JaineRatush/Mini-Tow-Tank/README.md

# Mini-Tow-Tank [Jun-Jul 2026]
Developed a mini tow tank to support research on bioluminescent algae as an alternative flow visualization technique. The control system uses closed-loop encoder feedback to achieve precise velocity(+/- 0.03 m/s from target) and repeatable motion, creating the flow conditions required for observing Kármán vortices in algae.

[Documentation & Instructions PDF](Documentation/MiniTowTank_Instructions&Documentation.pdf)  

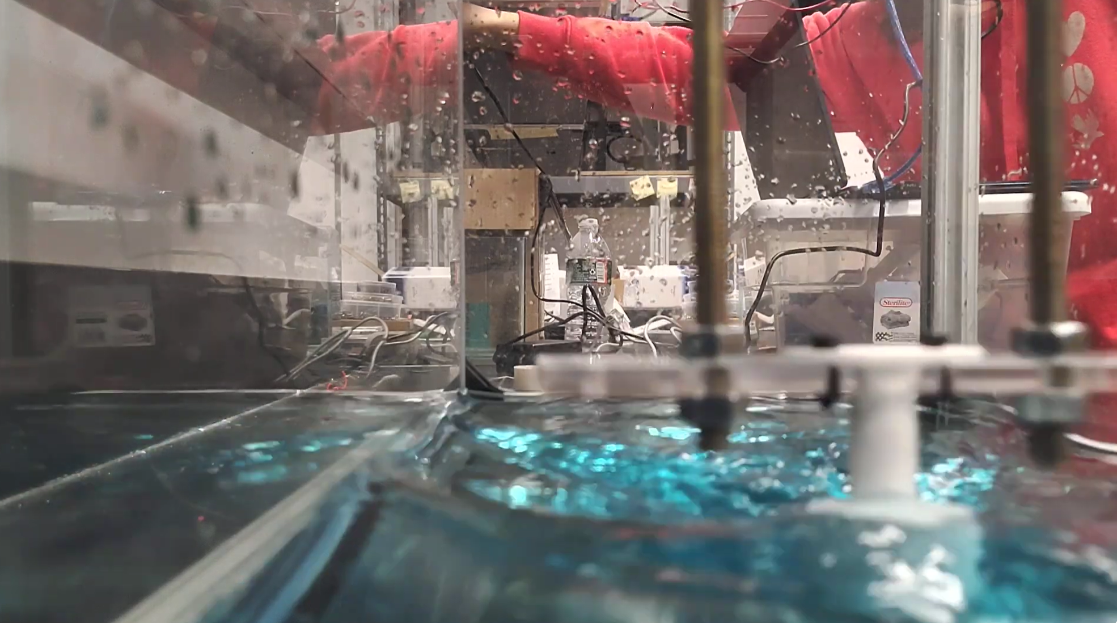
[picture p1: Photos/Thumbnail.png]
Mini Tow Tank Demo (https://www.youtube.com/watch?v=F2ftbyinyw4g)
  
Click on the image above to see it in action!  
Video link: (https://www.youtube.com/watch?v=F2ftbyinyw4)  

## Mechanical
- Applied first principles and Desmos to size and choose a DC motor, pulley diameter, determine electrical constraints, and choose the motor driver and corresponding wires (https://www.desmos.com/calculator/bqttl8z7cw)      
- Used Onshape to design and 3D print(gyroid infill to withstand shear stress) the [belt tensioner](Photos/BeltTensioner.png) sub-assembly and tow body.   
- Created a [height adjustable gantry](Photos/Gantry.jpg) (to minimize tow body deflection at any fluid level) by laser cutting acrylic and using M8 threaded rods and nuts.   
- Machined an [adapter sleeve](Photos/AdapterSleeve.jpeg) (4mm motor shaft to 5mm inner-bore pulley) using a manual mill and lathe, created a platform for electronics using a table saw and drill press  

## Controls  
- Scripted a [motor controller](Code/Tow_Tank_Motion.ino) in C++ by taking the derivative of encoder position feedback to determine velocity, and creating functions to assign motor direction based on conditional statements.   
- Scripted and tuned a PI controller with feedforward   
- Wrote a [calibration program](Code/Kff_Calibration.ino) to empirically determine baseline/feedforward PWM for a desired velocity  
 
## Electrical  
- Created an embedded circuit containing an IBT2 motor driver, Arduino Uno, DC motor, ultrasound proximity sensor, and a relative magnetic encoder.   
- Learned about the different types of Encoders(Relative/Absolute, Magnetic/Rotary/Optic)
- Learned about Single H-Bridges & MOSFETs
- Learned about Low-Pass Filters 
- Wired & Created a [Wiring diagram](Photos/Electronics.png) for the electronics:
 {Arduino, Proximity Sensor, IBT2 Motor Driver, Motor, Magnetic Encoder}
 
## Future Improvements:
Mechanical:  
-	Gantry is height adjustable, but was not designed for constant and easy adjustment. Mini Tow Tank 2.0 will have one threaded rod, and one smooth rod with clamps, allowing for faster adjustment. 
-	The Laser printed top and bottom portion of the gantry can be re-laser cut such that the nuts sit farther away from the MGN9 carriages to reduce nut-loosening vibrations. 
- In a future iteration the Go Pro should be able to be mounted on the gantry  

Controls/Electrical:  
For the next iteration the following improvements could be made:
-	Add a homing button and a stop button 
- Using an absolute encoder instead of the current relative encoder
-	Better wire management and casing for electronics

Credit to Zara Bhuiyan for helping embed/redesign the belt tensioner for the hex screw.
