JaineRatush/Mini-Tow-Tank/Photos/AdapterSleeve.jpeg

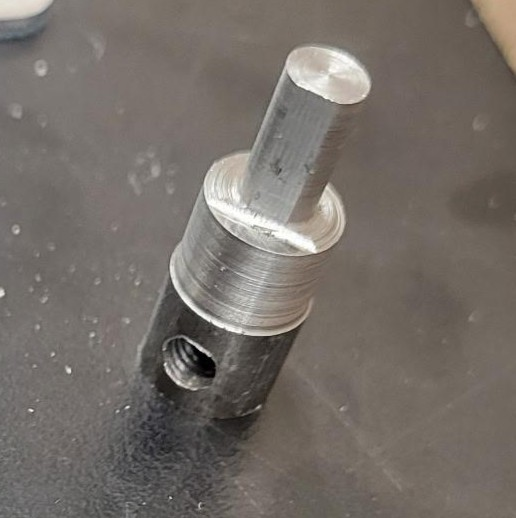
Photos/AdapterSleeve.jpeg
