JaineRatush/Mini-Tow-Tank/Photos/BeltTensioner.png

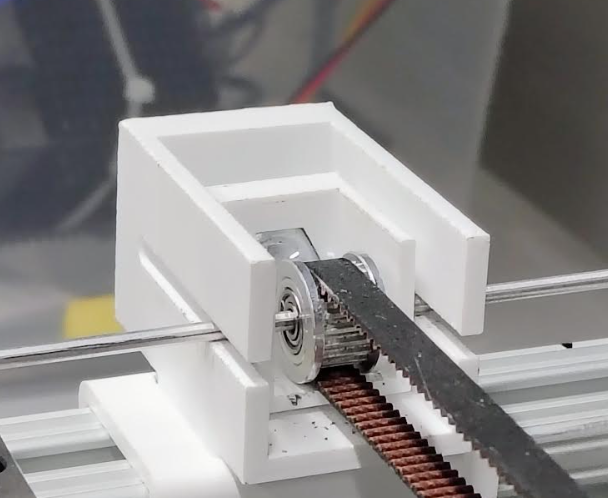
Photos/BeltTensioner.png
