JaineRatush/Mini-Tow-Tank/Photos/Electronics.png

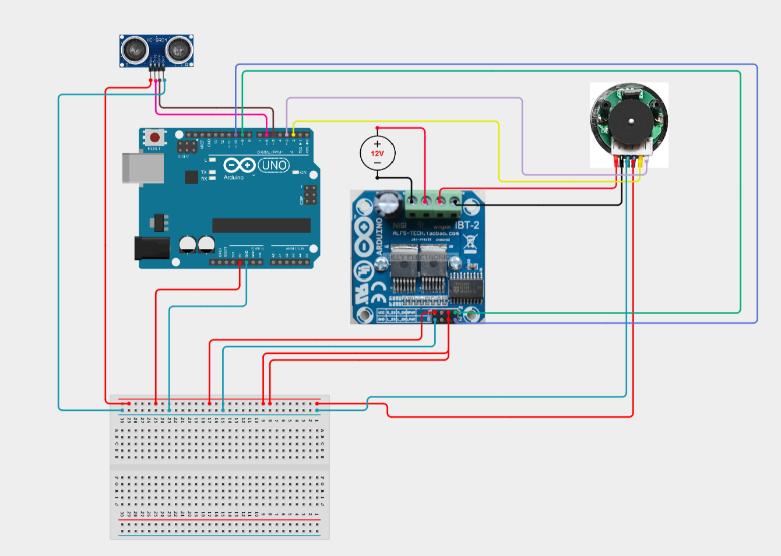
Photos/Electronics.png
