JaineRatush/Mini-Tow-Tank/Photos/Gantry.jpg

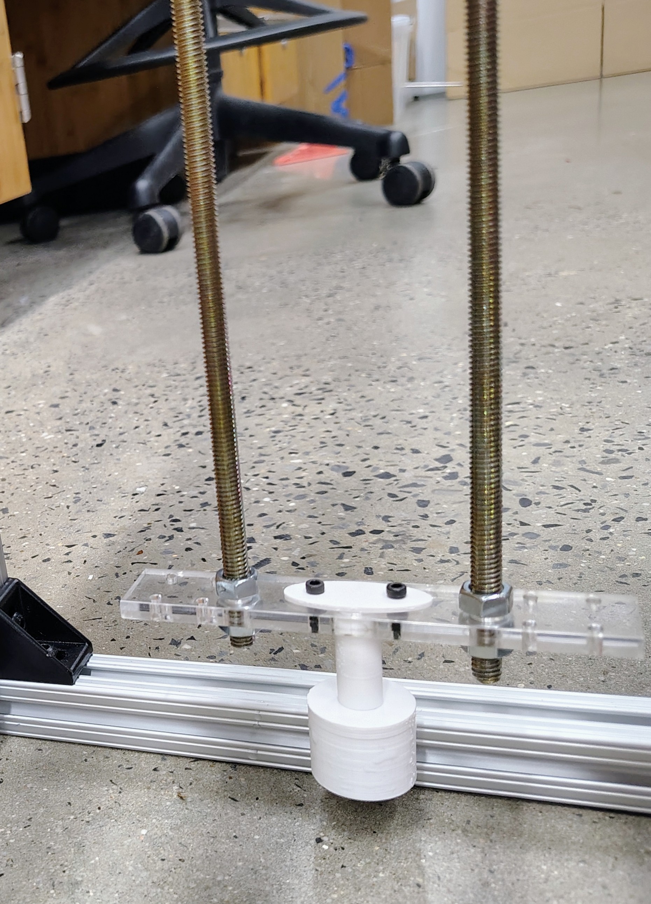
Photos/Gantry.jpg
