JaineRatush/Mini-Tow-Tank/Photos/Isometric.jpg

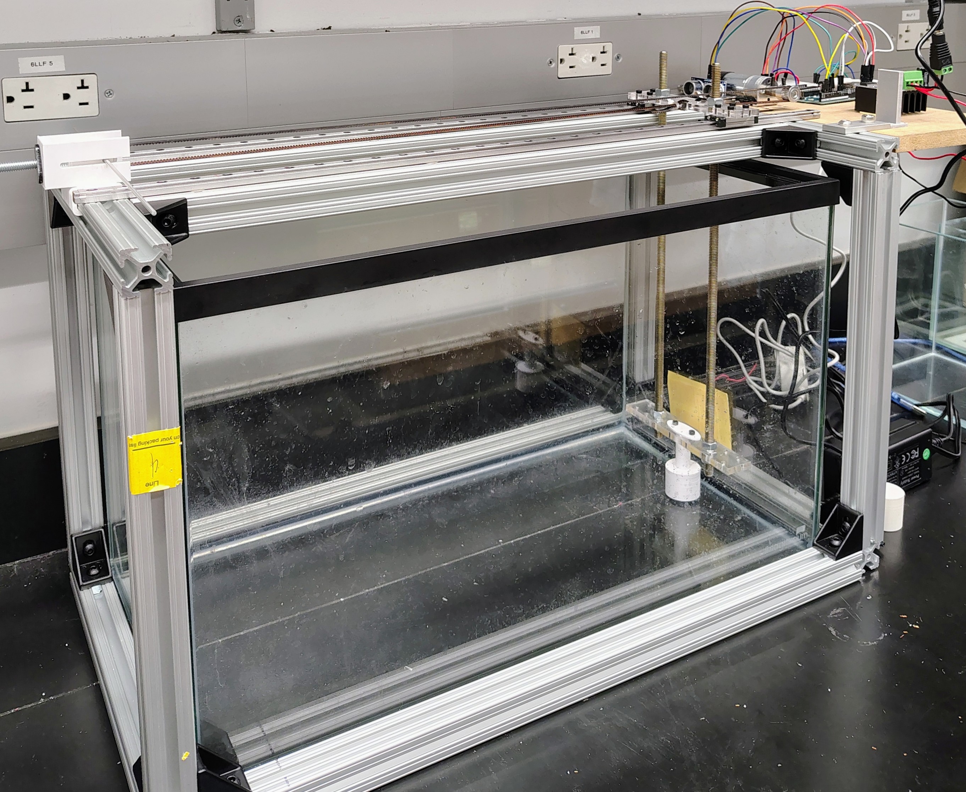
Photos/Isometric.jpg
