JaineRatush/Mini-Tow-Tank/Photos/Top Gantry + Electronics.jpg

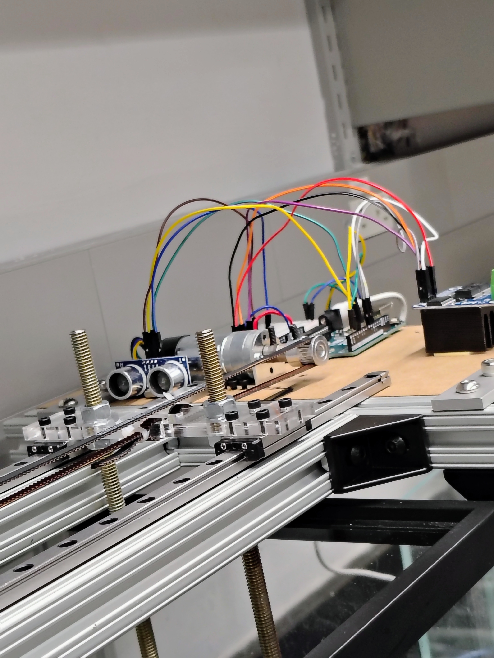
Photos/Top Gantry + Electronics.jpg
