JaineRatush/Mini-Tow-Tank/Photos/Top View ish.jpg

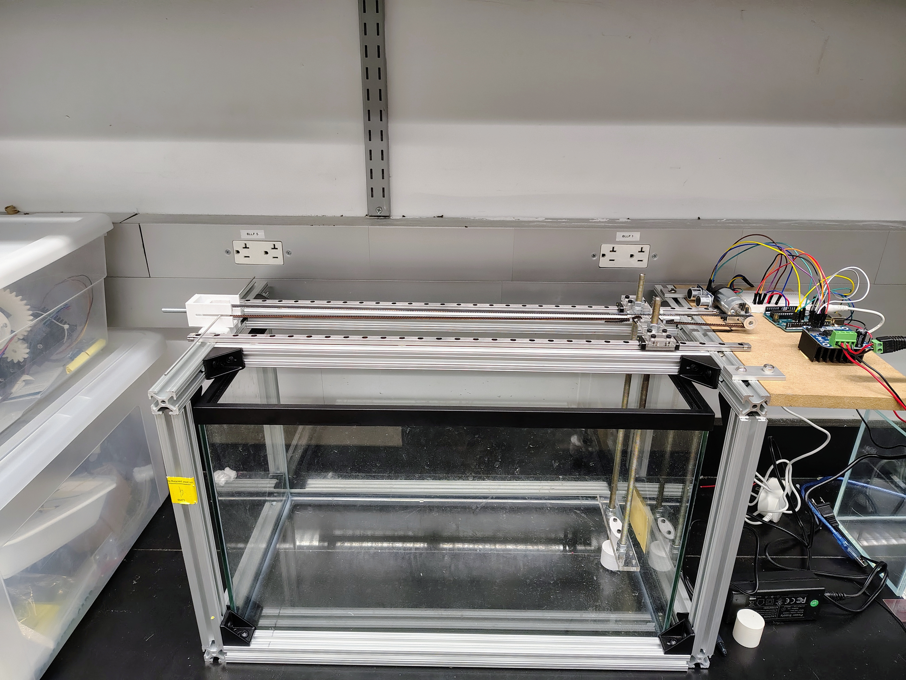
Photos/Top View ish.jpg
