JaineRatush/Mini-Tow-Tank/(commit log)

2026-08-07 Rename IMG_20260729_165146199_HDR_AE (1).jpg to Gantry and Electronics.jpg
2026-08-23 Rename Adapter and Motor Subassembly.jpg to AdapterMotorSubassembly.jpg
2026-08-23 Rename BeltTensioner (1).png to BeltTensioner.png
